airamez/medium-device/docs/dial-8in.pdf

A B

I

J

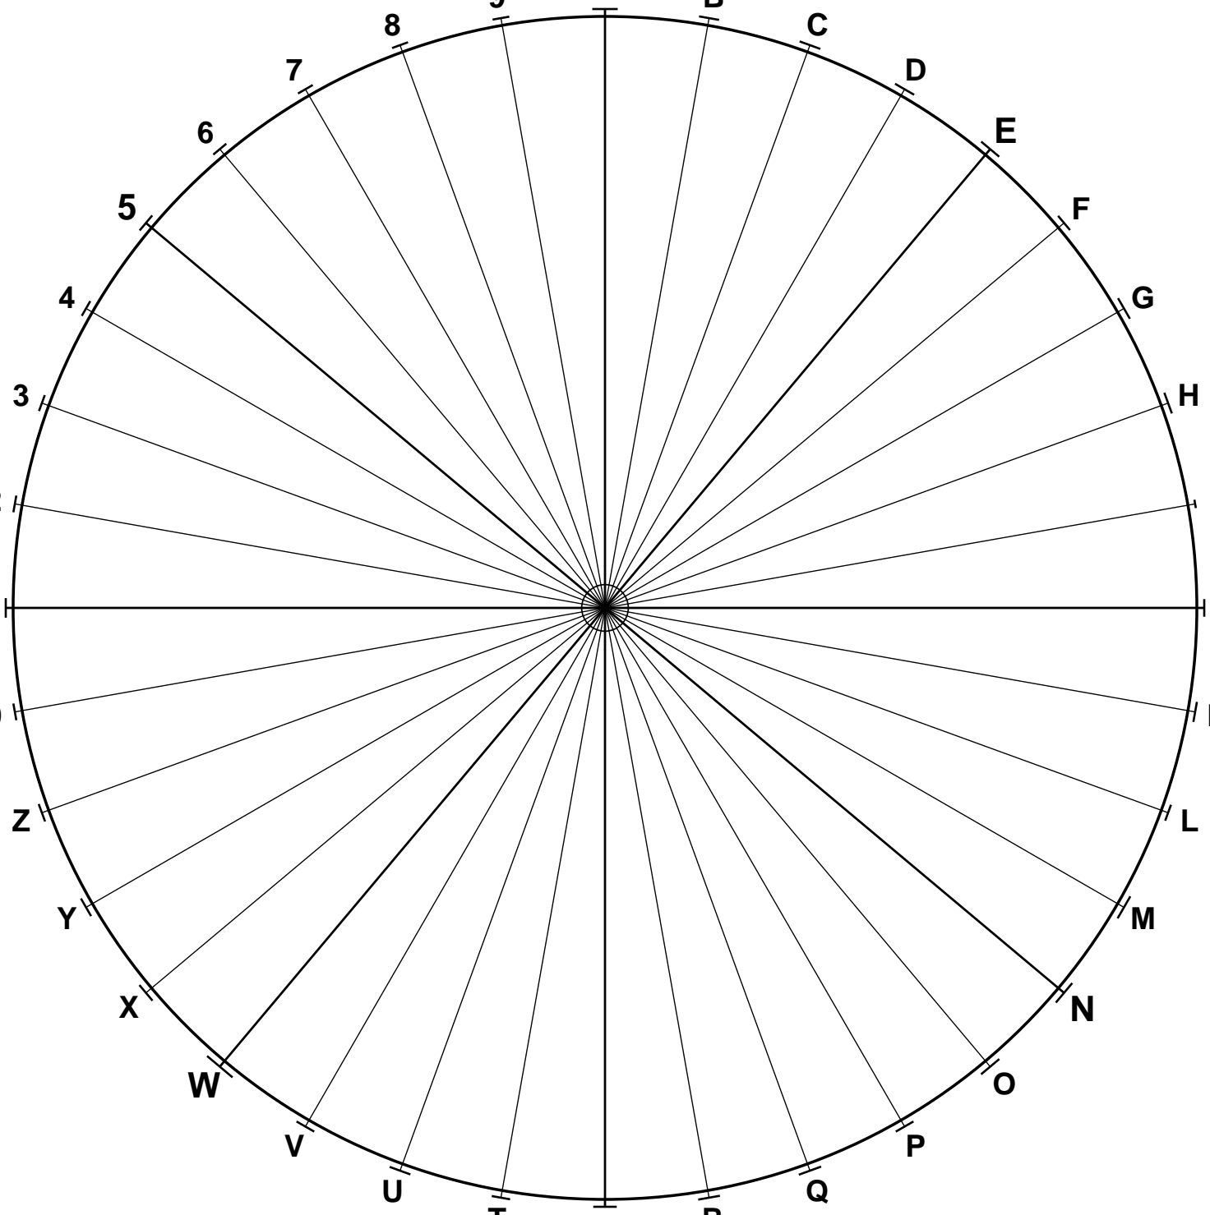
[picture p10: figure]

K

R S

T

0

1

2

9

### 8 in dial - 36 marks x 10 deg - A at North - print at 100% (no fit-to-page)

Cut on the circle. Letters sit outside. Align the 8 mm center with the bearing.
