airamez/medium-device/docs/as5600-breadboard-adafruit.jpg

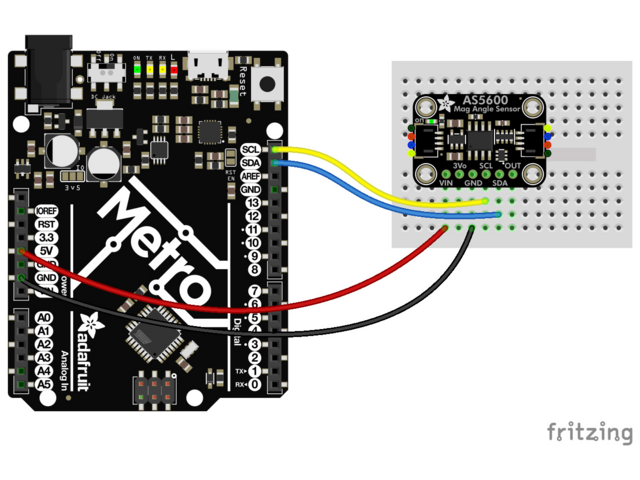
docs/as5600-breadboard-adafruit.jpg
